fvdpol/CVE_Controller/Hardware/4 Channel 5V Relay Module/483001213_o.jpg

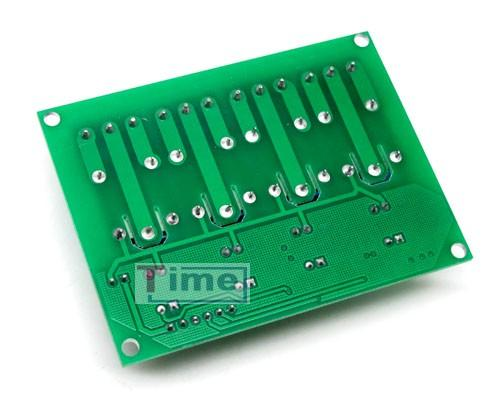
Hardware/4 Channel 5V Relay Module/483001213_o.jpg
