fvdpol/CVE_Controller/CVE_Controller/types.h

#ifndef _types_h
#define _type_h


typedef enum {
    SPEED_UNDEFINED = -1,
    SPEED_0 = 0,
    SPEED_1 = 1,
    SPEED_2 = 2,
    SPEED_3 = 3
} fanspeed_t; 


#endif
