fvdpol/CVE_Controller/(commit log)

2016-04-04 Add pictures for 4 Channel 5V Relay Module
2016-04-04 Update I/O Pin Assignment
2016-04-04 Update to mini-HA Framework
2016-04-05 update sensor detection, avoid hang if no sensor present
    [CVE_Controller.ino]
2016-04-12 Add schematic for relay output
2016-06-01 add switch/relay definitions
2016-06-01 basic handling of input switch
2016-06-01 loopback switch to fan
2016-09-17 rework speed selection logic
    [CVE_Controller.ino]
2016-09-19 separate measure/report task; add exponentional smoothing filter for measurements
